AYUSH-pro-grammer/GD32F450-devboard/bom.csv

Name | Designator | Quantity | Footprint | LCSC Part Number | Unit Price (USD) | Total Price (USD) | URL
100nF capacitor | C1,C4,C7,C9,C10,C11,C12,C13,C20,C21,C22,C23,C24,C25,C26,C31,C14,C15,C16,C17,C18,C19,C28 | 23 | Capacitor_SMD:C_0402_1005Metric | C1525 | 0.0046 | 0.1058 | https://www.lcsc.com/product-detail/C1525.html
10pF capacitor | C2,C3 | 2 | Capacitor_SMD:C_0402_1005Metric | C3860506 | 0.0052 | 0.0104 | https://www.lcsc.com/product-detail/C3860506.html
22pF capacitor | C5,C6 | 2 | Capacitor_SMD:C_0402_1005Metric | C1555 | 0.0043 | 0.0086 | https://www.lcsc.com/product-detail/C1555.html
10uF capacitor | C8,C27 | 2 | Capacitor_SMD:C_0402_1005Metric | C163694 | 0.0135 | 0.0270 | https://www.lcsc.com/product-detail/C163694.html
22uF capacitor | C29,C30 | 2 | Capacitor_SMD:C_0603_1608Metric | C109448 | 0.0572 | 0.1144 | https://www.lcsc.com/product-detail/C109448.html
Dual Schottky diode common anode | D1,D2 | 2 | Package_TO_SOT_SMD:SOT-523 | C545547 | 0.0185 | 0.0370 | https://www.lcsc.com/product-detail/C545547.html
TVS diode | D3,D4 | 2 | Diode_SMD:D_SOD-882 | C266458 | 0.0162 | 0.0324 | https://www.lcsc.com/product-detail/C266458.html
TVS diode 5V candidate | D5,D6 | 2 | Diode_SMD:D_SMB | C260407 | 0.0412 | 0.0824 | https://www.lcsc.com/product-detail/C260407.html
Green LED | D7,D8,D9,D10,D11 | 5 | LED_SMD:LED_0402_1005Metric | C20608784 | 0.0146 | 0.0730 | https://www.lcsc.com/product-detail/C20608784.html
Resettable fuse 500mA candidate | F1 | 1 | Fuse:Fuse_0603_1608Metric | C210357 | 0.0458 | 0.0458 | https://www.lcsc.com/product-detail/C210357.html
40-pin FPC connector | J1 | 1 | Connector_FFC-FPC:Amphenol_F32Q-1A7x1-11040_1x40-1MP_P0.5mm_Horizontal | C7419877 | 0.1940 | 0.1940 | https://www.lcsc.com/product-detail/C7419877.html
40-pin FPC connector | J2 | 1 | Connector_FFC-FPC:Hirose_FH12-40S-0.5SH_1x40-1MP_P0.50mm_Horizontal | C202114 | 0.3856 | 0.3856 | https://www.lcsc.com/product-detail/C202114.html
MicroSD connector | J3 | 1 | Connector_Card:microSD_HC_Hirose_DM3AT-SF-PEJM5 | C114218 | 1.7896 | 1.7896 | https://www.lcsc.com/product-detail/C114218.html
USB-C receptacle | J4 | 1 | Connector_USB:USB_C_Receptacle_HRO_TYPE-C-31-M-12 | C165948 | 0.1724 | 0.1724 | https://www.lcsc.com/product-detail/C165948.html
8-pin header | J5 | 1 | Connector_PinHeader_2.54mm:PinHeader_1x08_P2.54mm_Vertical | C5156616 | 0.0320 | 0.0320 | https://www.lcsc.com/product-detail/C5156616.html
40-pin dual-row header | J6,J7 | 2 | Connector_PinHeader_2.54mm:PinHeader_2x20_P2.54mm_Vertical | C50980 | 0.2143 | 0.4286 | https://www.lcsc.com/product-detail/C50980.html
2.2uH inductor | L1 | 1 | Inductor_SMD:L_1008_2520Metric | C576403 | 0.1495 | 0.1495 | https://www.lcsc.com/product-detail/C576403.html
1M resistor | R1 | 1 | Resistor_SMD:R_0402_1005Metric | C26083 | 0.0026 | 0.0026 | https://www.lcsc.com/product-detail/C26083.html
10k resistor | R2,R3,R4,R5,R6,R7,R8,R9,R10,R11,R14 | 11 | Resistor_SMD:R_0402_1005Metric | C25744 | 0.0031 | 0.0341 | https://www.lcsc.com/product-detail/C25744.html
5.1k resistor | R12,R13 | 2 | Resistor_SMD:R_0402_1005Metric | C25905 | 0.0026 | 0.0052 | https://www.lcsc.com/product-detail/C25905.html
450k resistor | R17 | 1 | Resistor_SMD:R_0402_1005Metric | C25883 | 0.0026 | 0.0026 | https://www.lcsc.com/product-detail/C25883.html
100k resistor | R18 | 1 | Resistor_SMD:R_0402_1005Metric | C25741 | 0.0013 | 0.0013 | https://www.lcsc.com/product-detail/C25741.html
4.7k resistor | R19,R20,R21,R22,R23 | 5 | Resistor_SMD:R_0402_1005Metric | C25900 | 0.0029 | 0.0145 | https://www.lcsc.com/product-detail/C25900.html
Tactile push-button switch | SW1,SW2,SW3 | 3 | Button_Switch_SMD:SW_SPST_PTS810 | C116501 | 0.5832 | 1.7496 | https://www.lcsc.com/product-detail/C116501.html
256Mbit SDRAM candidate | U1 | 1 | Package_SO:TSOP-II-54_22.2x10.16mm_P0.8mm | C62246 | 6.1612 | 6.1612 | https://www.lcsc.com/product-detail/C62246.html
GD32F450ZGT6 MCU | U2 | 1 | GD32_Liangshanpai.bak:GD32F450ZGT6_LQFP144_20x20mm_P0.5mm | C180076 | 7.2594 | 7.2594 | https://www.lcsc.com/product-detail/C99163.html
W25Q128JVE SPI flash | U3 | 1 | Package_SON:WSON-8-1EP_8x6mm_P1.27mm_EP3.4x4.3mm | C2456297 | 3.8086 | 3.8086 | https://www.lcsc.com/product-detail/C2456297.html
AP63203WU regulator | U5 | 1 | Package_TO_SOT_SMD:TSOT-23-6 | C780769 | 0.7925 | 0.7925 | https://www.lcsc.com/product-detail/C780769.html
32.768kHz crystal | Y1 | 1 | Crystal:Crystal_SMD_3215-2Pin_3.2x1.5mm | C271654 | 0.1329 | 0.1329 | https://www.lcsc.com/product-detail/C271654.html
25MHz crystal candidate - verify frequency | Y3 | 1 | Crystal:Crystal_SMD_2016-4Pin_2.0x1.6mm | C7301943 | 0.0936 | 0.0936 | https://www.lcsc.com/product-detail/C7301943.html
Priced component subtotal |  |  |  |  |  | 23.7466
PCB fabrication - JLCPCB |  | 1 | 4-layer PCB |  | 30.00 | 30.00 | https://jlcpcb.com/
TOTAL - components plus PCB |  |  |  |  |  | 53.7466
