AYUSH-pro-grammer/GD32F450-devboard/3d/GD32F450.step

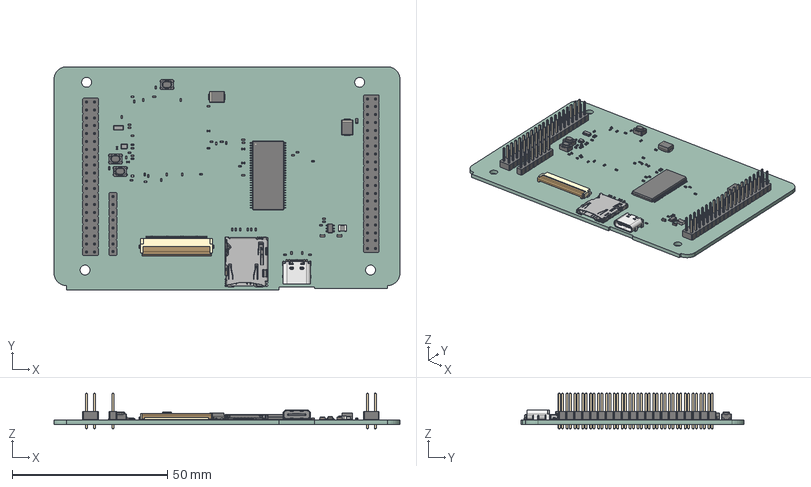
[picture p6: CAD file, 2026-11-05]
3d/GD32F450.step
111.5 x 72.0 x 11.5 mm
R_0402_1005Metric x 21
C_0402_1005Metric x 29
TSOP-II-54_22.2x10.16mm_P0.8mm
C_0603_1608Metric x 2
D_SMB x 2
Crystal_SMD_2016-4Pin_2.0x1.6mm
SW_SPST_PTS810 x 3
Fuse_0603_1608Metric
D_SOD-882 x 2
PinHeader_2x20_P254mm_Vertical x 2
LED_0402_1005Metric x 5
Crystal_SMD_3215-2Pin_3.2x1.5mm
TSOT-23-6
microSD_HC_Hirose_DM3AT-SF-PEJM5
PinHeader_1x08_P254mm_Vertical
lock
pins
L_1008_2520Metric
ConPins
PcbPins
Mold
Frame
GD32F450-unsaved-export-vjajDl_PCB
