AYUSH-pro-grammer/GD32F450-devboard/kicad/GD32F450.kicad_pcb

## KiCad design kicad/GD32F450.kicad_pcb (2026-11-05)

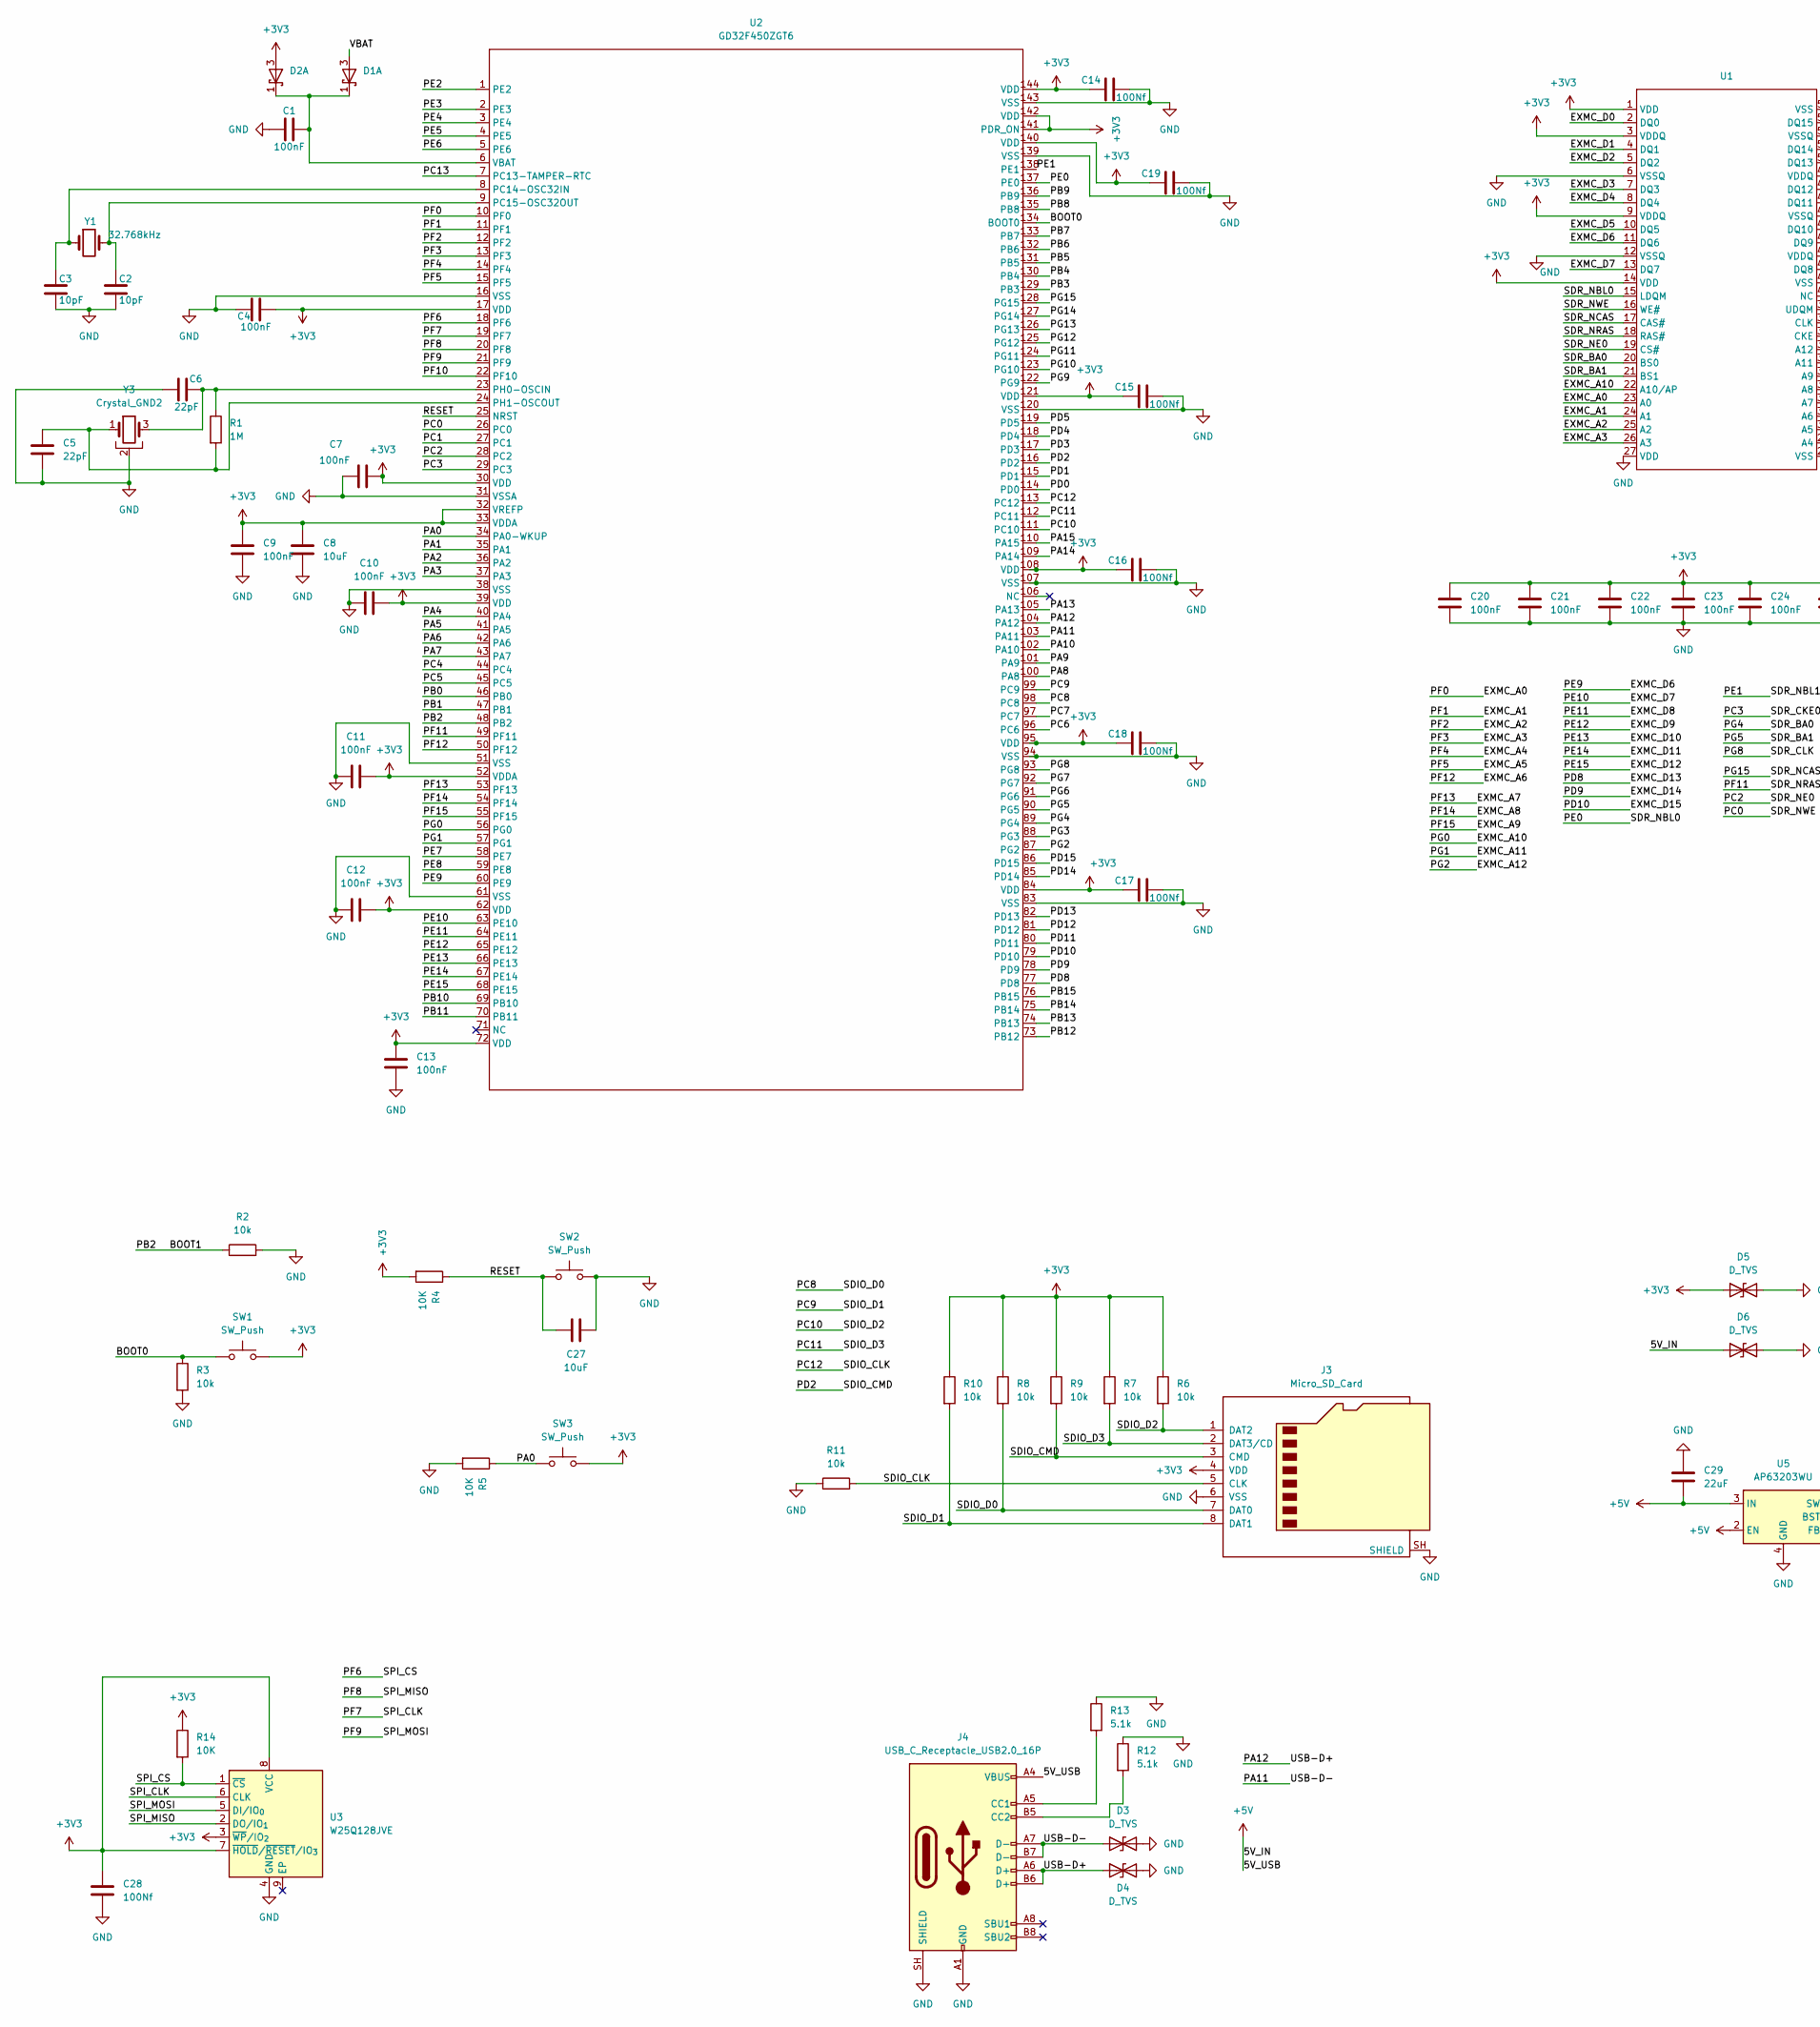
[picture p7: schematic GD32F450.kicad_sch, part in row 1, column 1]

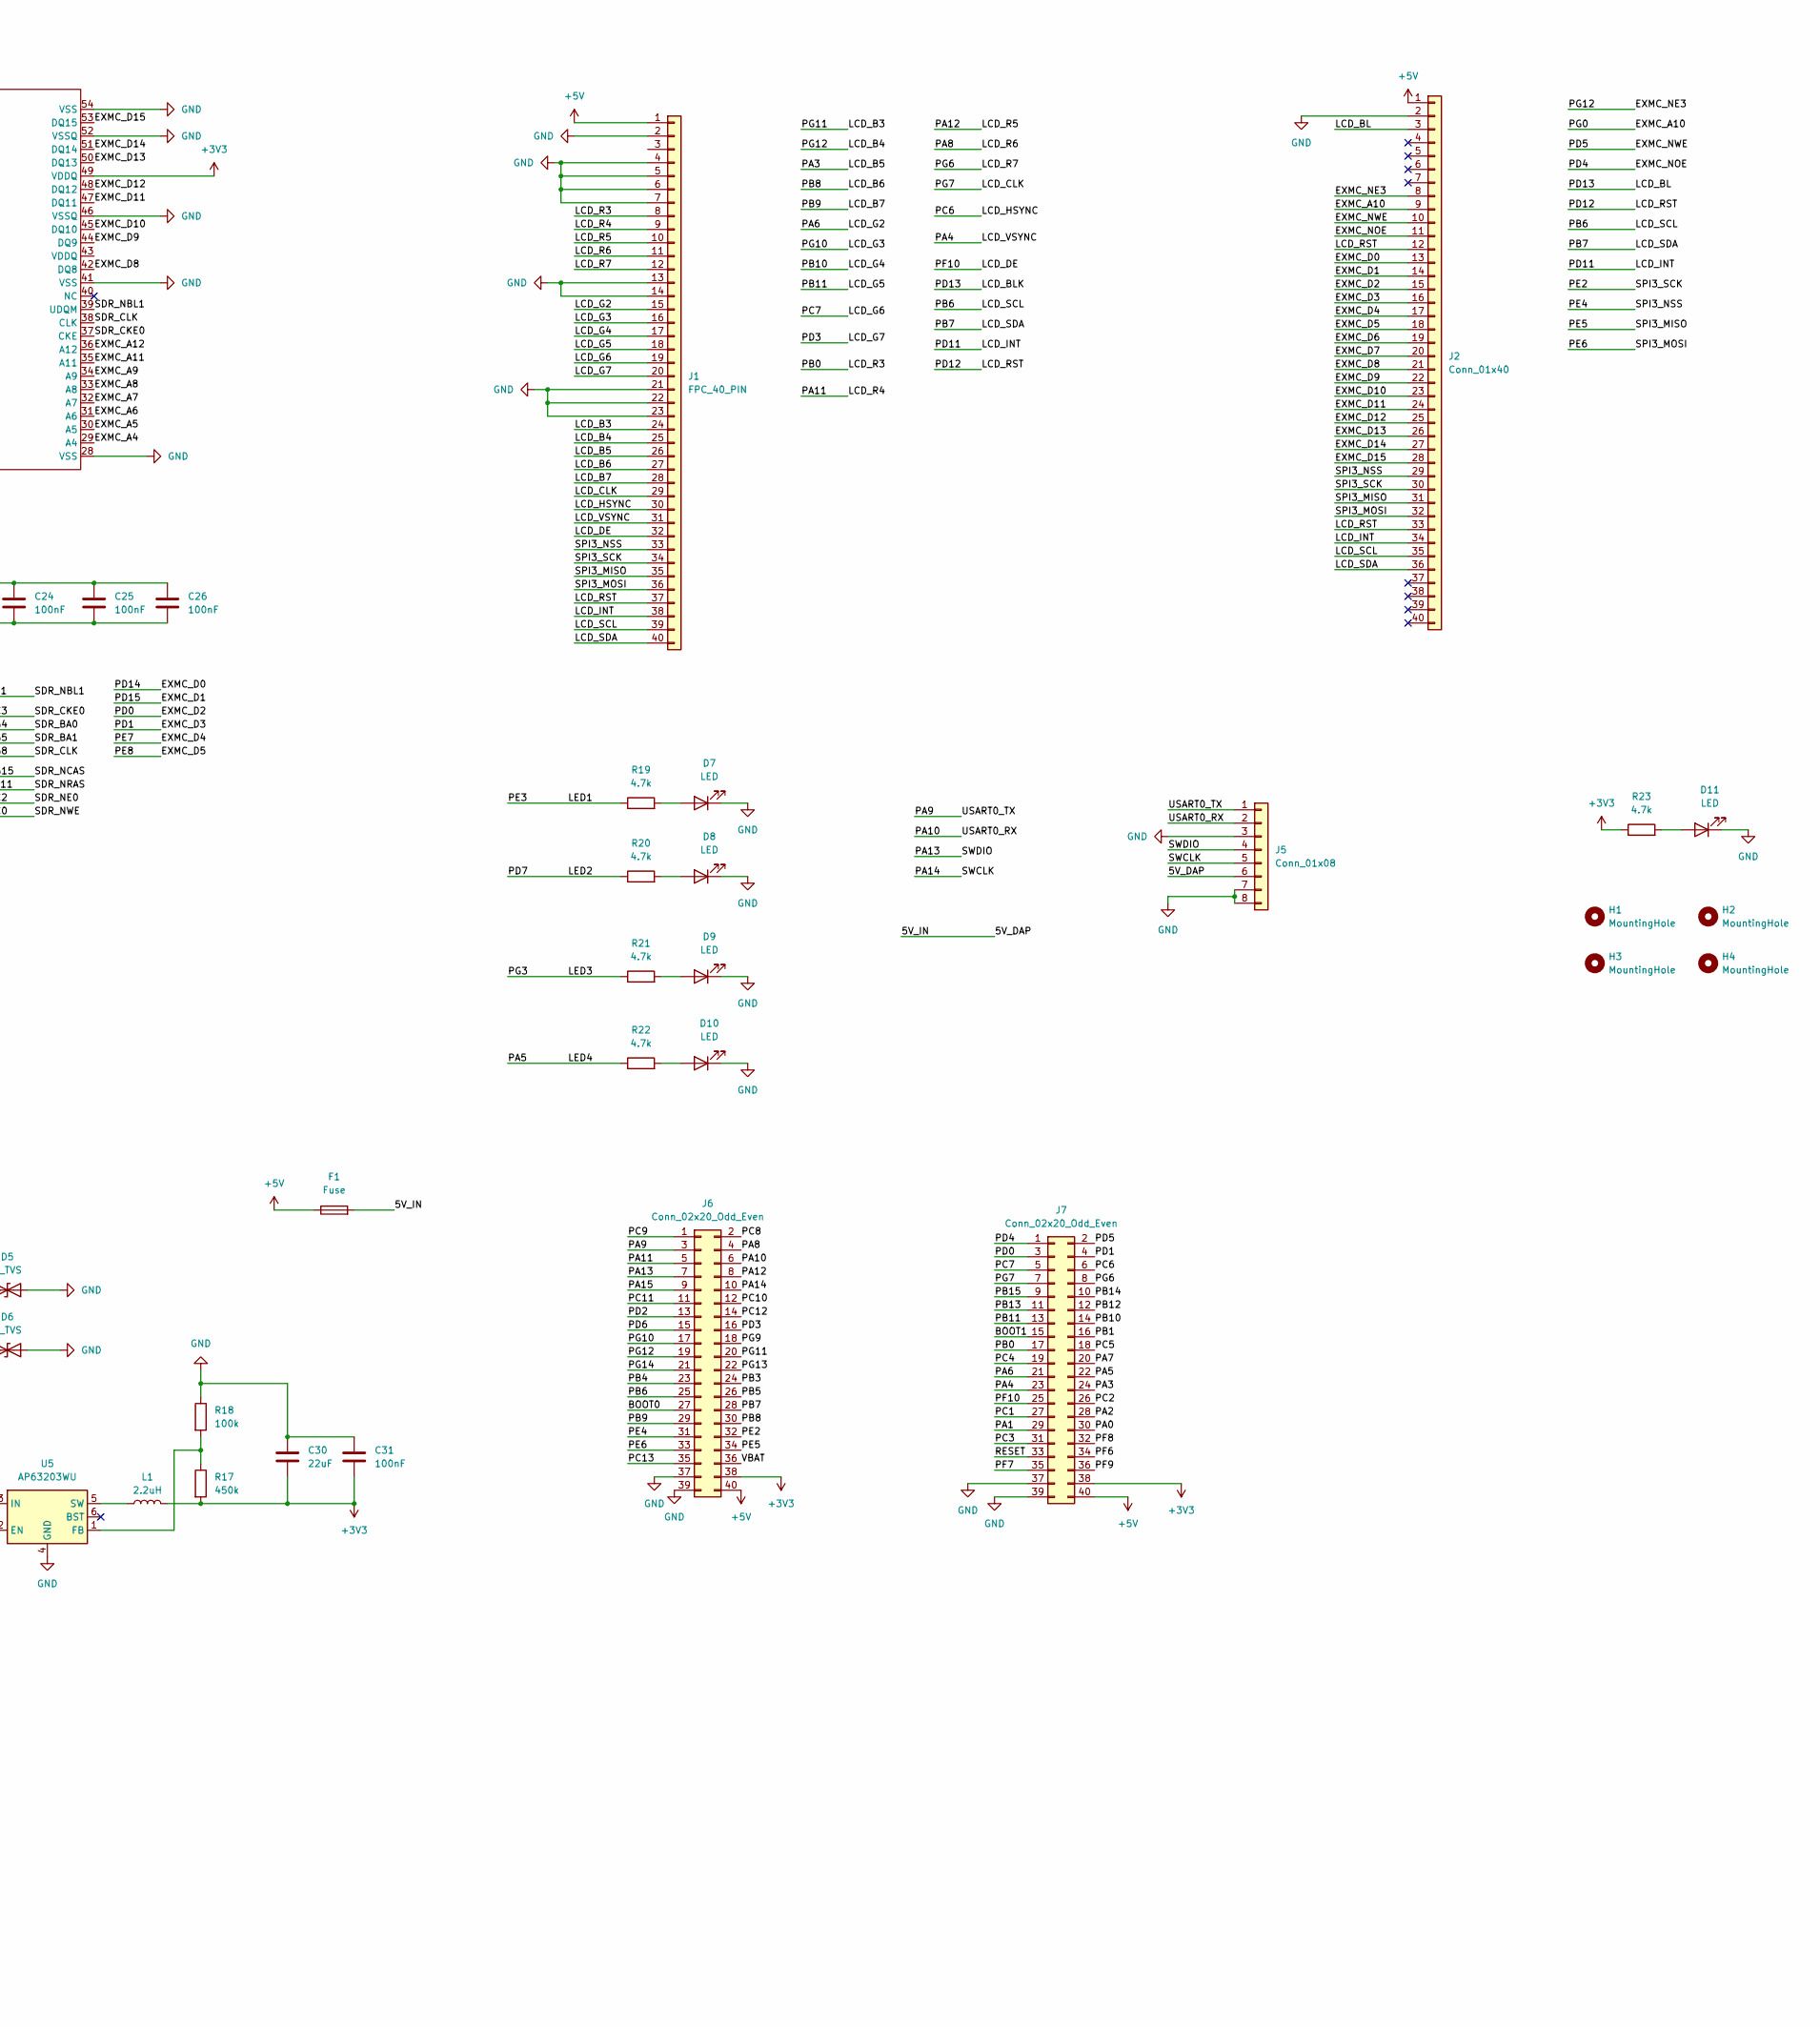
[picture p8: schematic GD32F450.kicad_sch, part in row 1, column 2]

Parts:
C1, C4, C7, C9, C10, C11, C12, C13, C20, C21, C22, C23, C24, C25, C26, C31: 100nF; C_0402_1005Metric
C2, C3: 10pF; C_0402_1005Metric
C5, C6: 22pF; C_0402_1005Metric
C8, C27: 10uF; C_0402_1005Metric
C14, C15, C16, C17, C18, C19, C28: 100Nf; C_0402_1005Metric
C29, C30: 22uF; C_0603_1608Metric
D1, D2: D_Schottky_Dual_CommonAnode_KKA_Split; SOT-523
D3, D4: D_TVS; D_SOD-882
D5, D6: D_TVS; D_SMB
D7, D8, D9, D10, D11: LED; LED_0402_1005Metric
F1: Fuse; Fuse_0603_1608Metric
H1, H2, H3, H4: MountingHole; MountingHole_3.2mm_M3
J1: FPC_40_PIN; Amphenol_F32Q-1A7x1-11040_1x40-1MP_P0.5mm_Horizontal
J2: Conn_01x40; Hirose_FH12-40S-0.5SH_1x40-1MP_P0.50mm_Horizontal
J3: Micro_SD_Card; microSD_HC_Hirose_DM3AT-SF-PEJM5
J4: USB_C_Receptacle_USB2.0_16P; USB_C_Receptacle_HRO_TYPE-C-31-M-12
J5: Conn_01x08; PinHeader_1x08_P2.54mm_Vertical
J6, J7: Conn_02x20_Odd_Even; PinHeader_2x20_P2.54mm_Vertical
L1: 2.2uH; L_1008_2520Metric
R1: 1M; R_0402_1005Metric
R2, R3, R6, R7, R8, R9, R10, R11: 10k; R_0402_1005Metric
R4, R5, R14: 10K; R_0402_1005Metric
R12, R13: 5.1k; R_0402_1005Metric
R17: 450k; R_0402_1005Metric
R18: 100k; R_0402_1005Metric
R19, R20, R21, R22, R23: 4.7k; R_0402_1005Metric
SW1, SW2, SW3: SW_Push; SW_SPST_PTS810
U1: TSOP-II-54_22.2x10.16mm_P0.8mm
U2: GD32F450ZGT6; GD32F450ZGT6_LQFP144_20x20mm_P0.5mm
U3: W25Q128JVE; WSON-8-1EP_8x6mm_P1.27mm_EP3.4x4.3mm
U5: AP63203WU; TSOT-23-6
Y1: 32.768kHz; Crystal_SMD_3215-2Pin_3.2x1.5mm
Y3: Crystal_GND2; Crystal_SMD_2016-4Pin_2.0x1.6mm

Connections:
+3V3: C4.2, C7.2, C8.1, C9.1, C10.2, C11.2, C12.2, C13.1, C14.1, C15.1, C16.1, C17.1, C18.1, C19.1, C20.1, C21.1, C22.1, C23.1, C24.1, C25.1, C26.1, C28.1, C30.2, C31.2, D2.3 (A), D5.1 (A1), J3.4 (VDD), J6.38, J7.38, L1.2, R4.2, R6.1, R7.1, R8.1, R9.1, R10.1, R14.1, R17.2, R23.1, SW1.2, SW3.2, U1.1 (VDD), U1.3 (VDDQ), U1.9 (VDDQ), U1.14 (VDD), U1.49 (VDDQ), U2.17 (VDD), U2.30 (VDD), U2.32 (VREFP), U2.33 (VDDA), U2.39 (VDD), U2.52 (VDDA), U2.62 (VDD), U2.72 (VDD), U2.84 (VDD), U2.95 (VDD), U2.108 (VDD), U2.121 (VDD), U2.140 (VDD), U2.141 (PDR_ON), U2.142 (VDD), U2.144 (VDD), U3.3 (~WP/IO_{2}), U3.7 (~HOLD/~RESET/IO_{3}), U3.8 (VCC)
+5V: C29.2, D6.1 (A1), F1.1, F1.2, J1.1, J2.1, J4.A4 (VBUS), J4.A9 (VBUS), J4.B4 (VBUS), J4.B9 (VBUS), J5.6, J6.40, J7.40, U5.2 (EN), U5.3 (IN)
/BOOT0: J6.27, R3.1, SW1.1, U2.134 (BOOT0)
/BOOT1: J7.15, R2.1, U2.48 (PB2)
/EXMC_A0: U1.23 (A0), U2.10 (PF0)
/EXMC_A1: U1.24 (A1), U2.11 (PF1)
/EXMC_A2: U1.25 (A2), U2.12 (PF2)
/EXMC_A3: U1.26 (A3), U2.13 (PF3)
/EXMC_A4: U1.29 (A4), U2.14 (PF4)
/EXMC_A5: U1.30 (A5), U2.15 (PF5)
/EXMC_A6: U1.31 (A6), U2.50 (PF12)
/EXMC_A7: U1.32 (A7), U2.53 (PF13)
/EXMC_A8: U1.33 (A8), U2.54 (PF14)
/EXMC_A9: U1.34 (A9), U2.55 (PF15)
/EXMC_A10: J2.9, U1.22 (A10/AP), U2.56 (PG0)
/EXMC_A11: U1.35 (A11), U2.57 (PG1)
/EXMC_A12: U1.36 (A12), U2.87 (PG2)
/EXMC_D0: J2.13, U1.2 (DQ0), U2.85 (PD14)
/EXMC_D1: J2.14, U1.4 (DQ1), U2.86 (PD15)
/EXMC_D2: J2.15, J7.3, U1.5 (DQ2), U2.114 (PD0)
/EXMC_D3: J2.16, J7.4, U1.7 (DQ3), U2.115 (PD1)
/EXMC_D4: J2.17, U1.8 (DQ4), U2.58 (PE7)
/EXMC_D5: J2.18, U1.10 (DQ5), U2.59 (PE8)
/EXMC_D6: J2.19, U1.11 (DQ6), U2.60 (PE9)
/EXMC_D7: J2.20, U1.13 (DQ7), U2.63 (PE10)
/EXMC_D8: J2.21, U1.42 (DQ8), U2.64 (PE11)
/EXMC_D9: J2.22, U1.44 (DQ9), U2.65 (PE12)
/EXMC_D10: J2.23, U1.45 (DQ10), U2.66 (PE13)
/EXMC_D11: J2.24, U1.47 (DQ11), U2.67 (PE14)
/EXMC_D12: J2.25, U1.48 (DQ12), U2.68 (PE15)
/EXMC_D13: J2.26, U1.50 (DQ13), U2.77 (PD8)
/EXMC_D14: J2.27, U1.51 (DQ14), U2.78 (PD9)
/EXMC_D15: J2.28, U1.53 (DQ15), U2.79 (PD10)
/EXMC_NE3: J1.25, J2.8, J6.19, U2.125 (PG12)
/EXMC_NOE: J2.11, J7.1, U2.118 (PD4)
/EXMC_NWE: J2.10, J7.2, U2.119 (PD5)
/LCD_B3: J1.24, J6.20, U2.124 (PG11)
/LCD_B5: J1.26, J7.24, U2.37 (PA3)
/LCD_B6: J1.27, J6.30, U2.135 (PB8)
/LCD_B7: J1.28, J6.29, U2.136 (PB9)
/LCD_BL: J2.3, U2.82 (PD13)
/LCD_CLK: J1.29, J7.7, U2.92 (PG7)
/LCD_DE: J1.32, J7.25, U2.22 (PF10)
/LCD_G2: J1.15, J7.21, U2.42 (PA6)
/LCD_G3: J1.16, J6.17, U2.123 (PG10)
/LCD_G4: J1.17, J7.14, U2.69 (PB10)
/LCD_G5: J1.18, J7.13, U2.70 (PB11)
/LCD_G6: J1.19, J7.5, U2.97 (PC7)
/LCD_G7: J1.20, J6.16, U2.117 (PD3)
/LCD_HSYNC: J1.30, J7.6, U2.96 (PC6)
/LCD_INT: J1.38, J2.34, U2.80 (PD11)
/LCD_R3: J1.8, J7.17, U2.46 (PB0)
/LCD_R4: D3.1 (A1), J1.9, J4.A7 (D-), J4.B7 (D-), J6.5, U2.103 (PA11)
/LCD_R5: D4.1 (A1), J1.10, J4.A6 (D+), J4.B6 (D+), J6.8, U2.104 (PA12)
/LCD_R6: J1.11, J6.4, U2.100 (PA8)
/LCD_R7: J1.12, J7.8, U2.91 (PG6)
/LCD_RST: J1.37, J2.12, J2.33, U2.81 (PD12)
/LCD_SCL: J1.39, J2.35, J6.25, U2.132 (PB6)
/LCD_SDA: J1.40, J2.36, J6.28, U2.133 (PB7)
/LCD_VSYNC: J1.31, J7.23, U2.40 (PA4)
/LED1: R19.1, U2.2 (PE3)
/LED2: R20.1
/LED3: R21.1, U2.88 (PG3)
/LED4: J7.22, R22.1, U2.41 (PA5)
/PA0: J7.30, R5.1, SW3.1, U2.34 (PA0-WKUP)
/PA1: J7.29, U2.35 (PA1)
/PA2: J7.28, U2.36 (PA2)
/PA7: J7.20, U2.43 (PA7)
/PA9: J5.1, J6.3, U2.101 (PA9)
/PA10: J5.2, J6.6, U2.102 (PA10)
/PA13: J5.4, J6.7, U2.105 (PA13)
/PA14: J5.5, J6.10, U2.109 (PA14)
/PA15: J6.9, U2.110 (PA15)
/PB1: J7.16, U2.47 (PB1)
/PB3: J6.24, U2.129 (PB3)
/PB4: J6.23, U2.130 (PB4)
/PB5: J6.26, U2.131 (PB5)
/PB12: J7.12, U2.73 (PB12)
/PB13: J7.11, U2.74 (PB13)
/PB14: J7.10, U2.75 (PB14)
/PB15: J7.9, U2.76 (PB15)
/PC0: U1.16 (WE#), U2.26 (PC0)
/PC1: J7.27, U2.27 (PC1)
/PC2: J7.26, U1.19 (CS#), U2.28 (PC2)
/PC3: J7.31, U1.37 (CKE), U2.29 (PC3)
/PC4: J7.19, U2.44 (PC4)
/PC5: J7.18, U2.45 (PC5)
/PC8: J3.7 (DAT0), J6.2, R8.2, U2.98 (PC8)
/PC9: J3.8 (DAT1), J6.1, R10.2, U2.99 (PC9)
/PC10: J3.1 (DAT2), J6.12, R6.2, U2.111 (PC10)
/PC11: J3.2 (DAT3/CD), J6.11, R7.2, U2.112 (PC11)
/PC12: J3.5 (CLK), J6.14, R11.2, U2.113 (PC12)
/PC13: J6.35, U2.7 (PC13-TAMPER-RTC)
/PD2: J3.3 (CMD), J6.13, R9.2, U2.116 (PD2)
/PD6: J6.15
/PE0: U1.15 (LDQM), U2.137 (PE0)
/PE1: U1.39 (UDQM), U2.138 (PE1)
/PE2: J1.34, J2.30, J6.32, U2.1 (PE2)
/PE4: J1.33, J2.29, J6.31, U2.3 (PE4)
/PE5: J1.35, J2.31, J6.34, U2.4 (PE5)
/PE6: J1.36, J2.32, J6.33, U2.5 (PE6)
/PF6: J7.34, R14.2, U2.18 (PF6), U3.1 (~CS)
/PF7: J7.35, U2.19 (PF7), U3.6 (CLK)
/PF8: J7.32, U2.20 (PF8), U3.2 (DO/IO_{1})
/PF9: J7.36, U2.21 (PF9), U3.5 (DI/IO_{0})
/PF11: U1.18 (RAS#), U2.49 (PF11)
/PG4: U1.20 (BS0), U2.89 (PG4)
/PG5: U1.21 (BS1), U2.90 (PG5)
/PG8: U1.38 (CLK), U2.93 (PG8)
/PG9: J6.18, U2.122 (PG9)
/PG13: J6.22, U2.126 (PG13)
/PG14: J6.21, U2.127 (PG14)
/PG15: U1.17 (CAS#), U2.128 (PG15)
/RESET: C27.1, J7.33, R4.1, SW2.1, U2.25 (NRST)
/VBAT: D1.3 (A), J6.36
GND: C1.2, C2.2, C3.2, C4.1, C5.2, C6.2, C7.1, C8.2, C9.2, C10.1, C11.1, C12.1, C13.2, C14.2, C15.2, C16.2, C17.2, C18.2, C19.2, C20.2, C21.2, C22.2, C23.2, C24.2, C25.2, C26.2, C27.2, C28.2, C29.1, C30.1, C31.1, D3.2 (A2), D4.2 (A2), D5.2 (A2), D6.2 (A2), D7.1 (K), D8.1 (K), D9.1 (K), D10.1 (K), D11.1 (K), J1.2, J1.4, J1.5, J1.6, J1.7, J1.13, J1.14, J1.21, J1.22, J1.23, J2.2, J3.6 (VSS), J3.SH (SHIELD), J4.A1 (GND), J4.A12 (GND), J4.B1 (GND), J4.B12 (GND), J4.SH (SHIELD), J5.3, J5.7, J5.8, J6.37, J6.39, J7.37, J7.39, R2.2, R3.2, R5.2, R11.1, R12.1, R13.1, R18.1, SW2.2, U1.6 (VSSQ), U1.12 (VSSQ), U1.27 (VDD), U1.28 (VSS), U1.41 (VSS), U1.46 (VSSQ), U1.52 (VSSQ), U1.54 (VSS), U2.16 (VSS), U2.31 (VSSA), U2.38 (VSS), U2.51 (VSS), U2.61 (VSS), U2.83 (VSS), U2.94 (VSS), U2.107 (VSS), U2.120 (VSS), U2.139 (VSS), U2.143 (VSS), U3.4 (GND), U5.4 (GND), Y3.2
unnamed: C1.1, D1.1 (K), D2.1 (K), U2.6 (VBAT)
unnamed: D7.2 (A), R19.2
unnamed: D8.2 (A), R20.2
unnamed: D9.2 (A), R21.2
unnamed: D10.2 (A), R22.2
unnamed: D11.2 (A), R23.2
unnamed: J4.A5 (CC1), R13.2
unnamed: J4.B5 (CC2), R12.2
unnamed: C3.1, U2.8 (PC14-OSC32IN), Y1.1
unnamed: C2.1, U2.9 (PC15-OSC32OUT), Y1.2
unnamed: C6.1, R1.1, U2.23 (PH0-OSCIN), Y3.3
unnamed: C5.1, R1.2, U2.24 (PH1-OSCOUT), Y3.1
unnamed: R17.1, R18.2, U5.1 (FB)
unnamed: L1.1, U5.5 (SW)

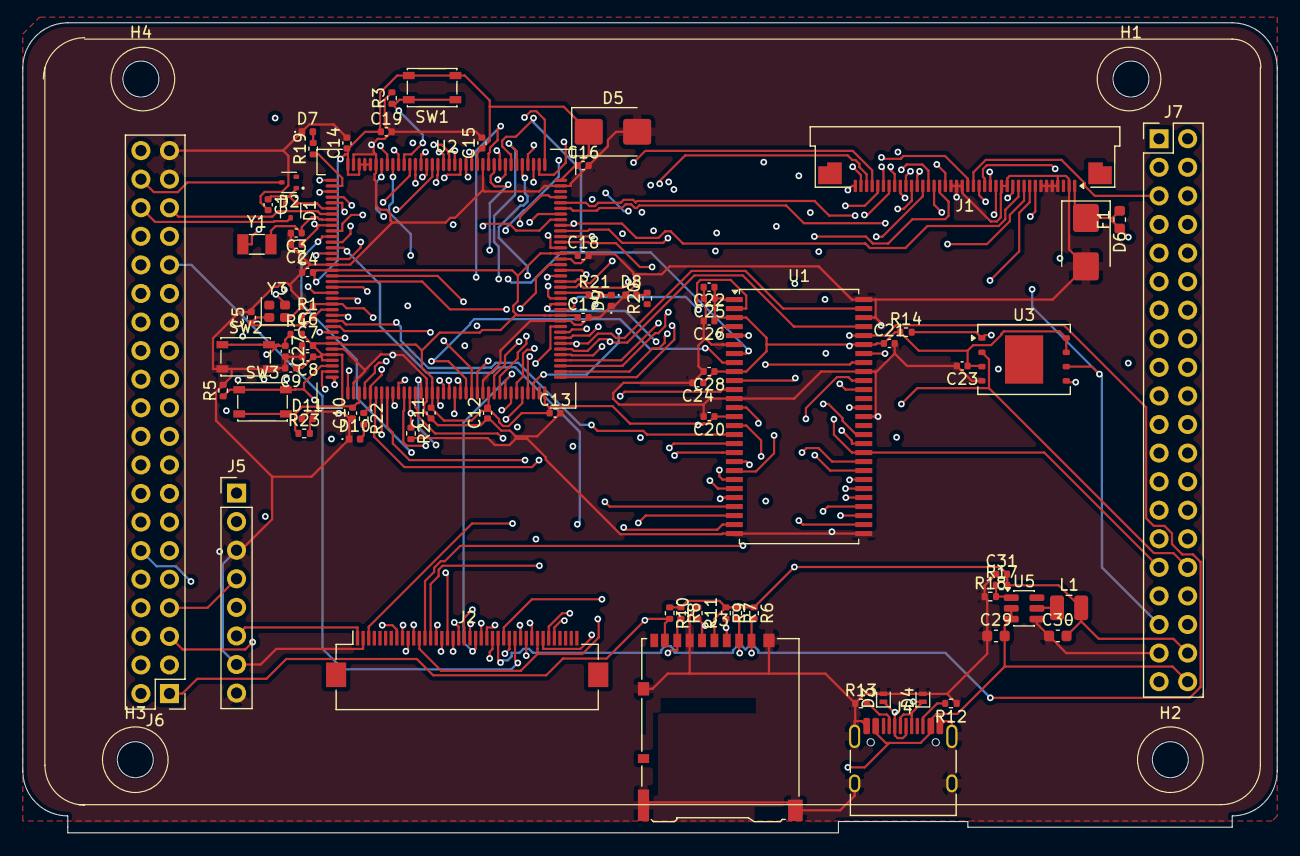
[picture p9: board GD32F450.kicad_pcb from above]

Board: 4 copper layers, 111.5 x 72.0 mm, 85 parts (0 on the bottom side), 128 nets.
