AYUSH-pro-grammer/GD32F450-devboard/firmware/include/board_config.h

#ifndef BOARD_CONFIG_H
#define BOARD_CONFIG_H

#ifndef GD32F450
#define GD32F450
#endif

#ifndef HXTAL_VALUE
#define HXTAL_VALUE 25000000U
#endif

#define BOARD_DEBUG_USART USART0
#define BOARD_DEBUG_GPIO GPIOA
#define BOARD_DEBUG_GPIO_CLOCK RCU_GPIOA
#define BOARD_DEBUG_USART_CLOCK RCU_USART0
#define BOARD_DEBUG_TX_PIN GPIO_PIN_9
#define BOARD_DEBUG_RX_PIN GPIO_PIN_10
#define BOARD_DEBUG_GPIO_AF GPIO_AF_7
#define BOARD_DEBUG_BAUDRATE 115200U

#define BOARD_RAM_TEST_WORDS 64U
#define BOARD_COMMAND_BUFFER_SIZE 40U

#endif
